MohammadAdib/ELRS-433/3D Files/STL/tripod_mount.stl

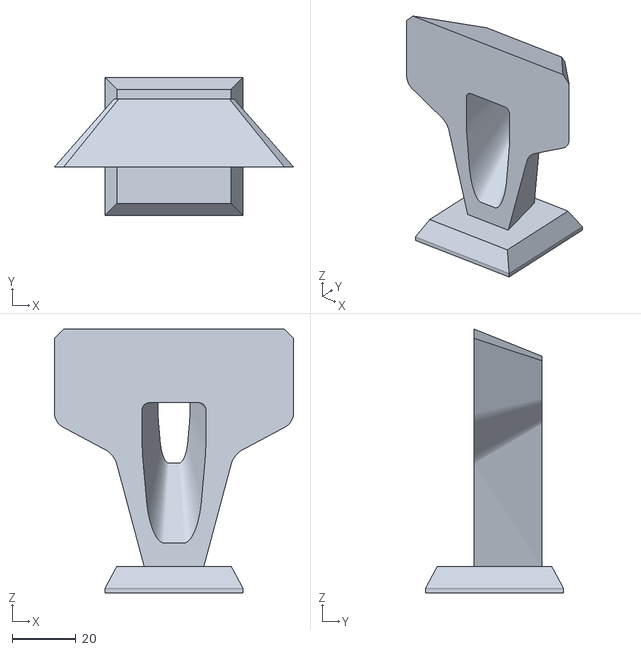
[picture p1: CAD file, 2023-04-14]
3D Files/STL/tripod_mount.stl
75.0 x 43.2 x 82.7
