MohammadAdib/ELRS-433/3D Files/STL/rx2.stl

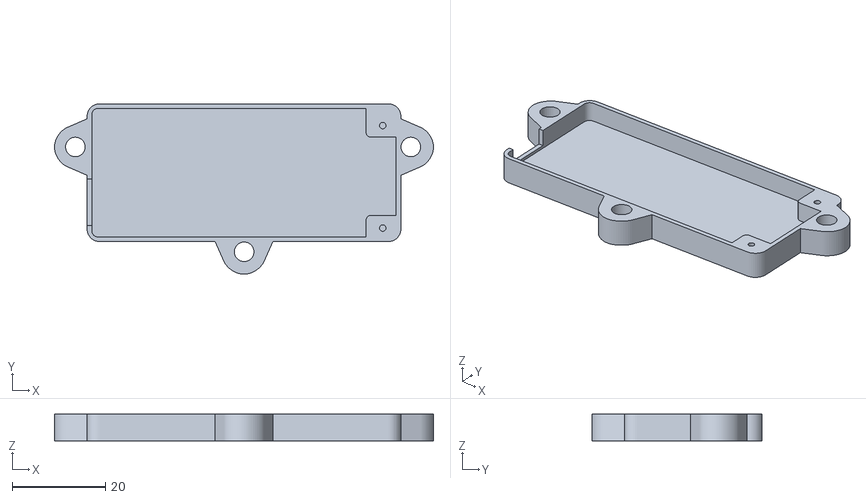
[picture p2: CAD file, 2023-04-14]
3D Files/STL/rx2.stl
81.3 x 36.6 x 5.70
