MohammadAdib/ELRS-433/3D Files/STL/tx1.stl

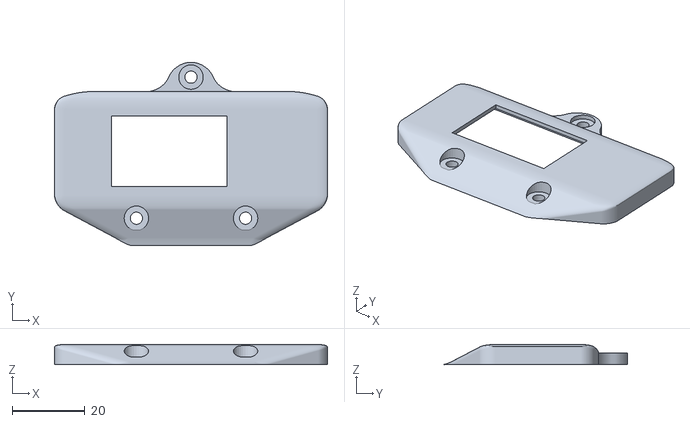
[picture p3: CAD file, 2023-04-14]
3D Files/STL/tx1.stl
75.0 x 50.3 x 5.50
