MohammadAdib/ELRS-433/3D Files/STL/tx2.stl

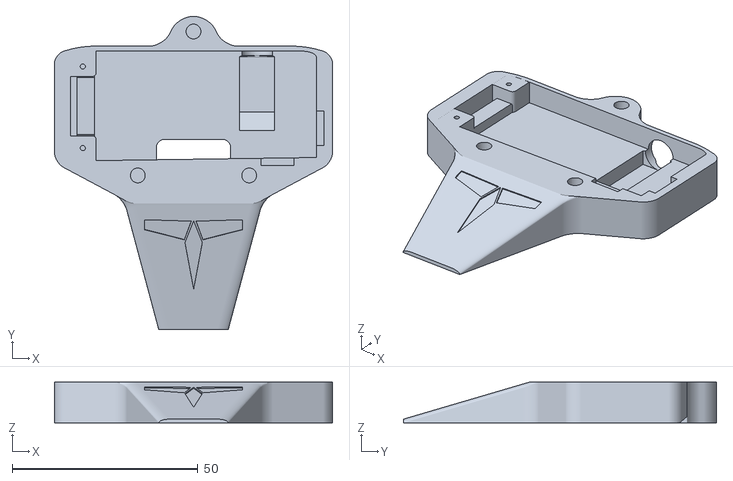
[picture p4: CAD file, 2023-04-14]
3D Files/STL/tx2.stl
75.0 x 84.3 x 11.0
