MohammadAdib/ELRS-433/3D Files/STL/rx1_no_text.stl

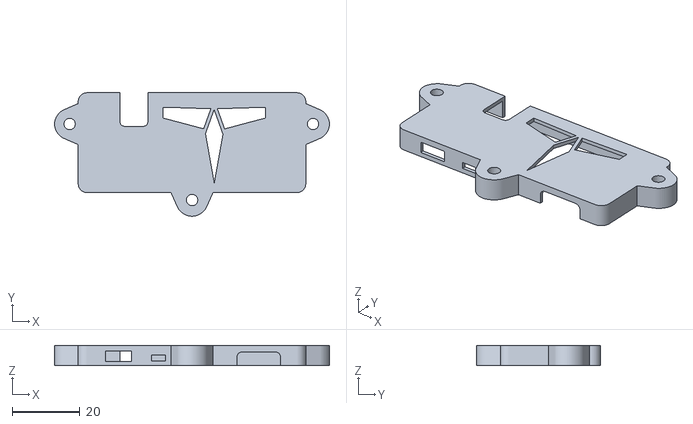
[picture p5: CAD file, 2023-04-14]
3D Files/STL/rx1_no_text.stl
81.3 x 36.6 x 5.94
