MohammadAdib/ELRS-433/3D Files/STL/rx1.stl

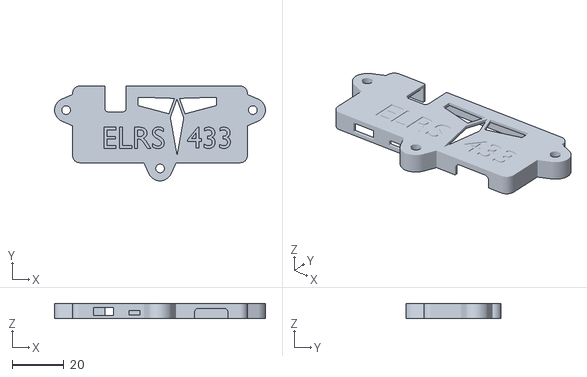
[picture p6: CAD file, 2023-04-14]
3D Files/STL/rx1.stl
81.3 x 36.6 x 5.94
