MohammadAdib/ELRS-433/3D Files/STL/tx3.stl

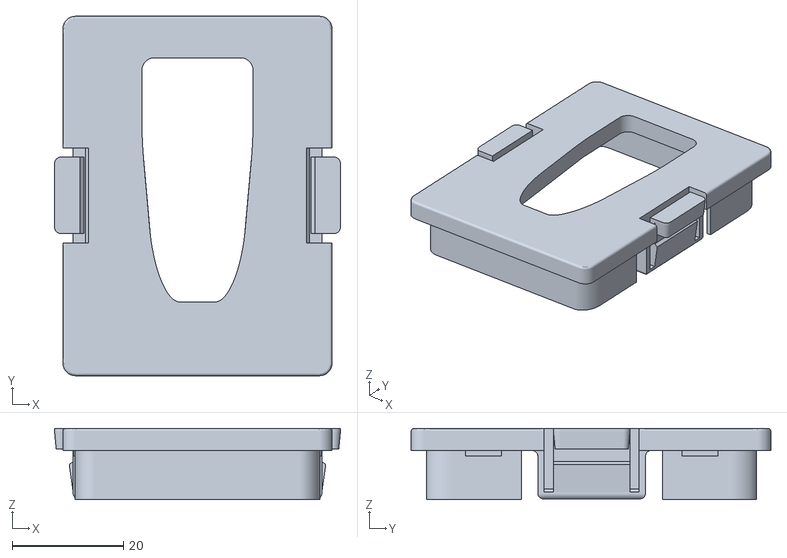
[picture p7: CAD file, 2023-04-14]
3D Files/STL/tx3.stl
51.5 x 64.8 x 12.8
