MohammadAdib/ELRS-433/(list of files, cad)

Other CAD files:
3D Files/STL/tx1_usb_slot.stl
3D Files/Blender/elrs433_tx_tripod.blend
